avaneeshharshakamath10-dotcom/Intelligent_Road_Anomaly_Detection_System/detection_result.jpg

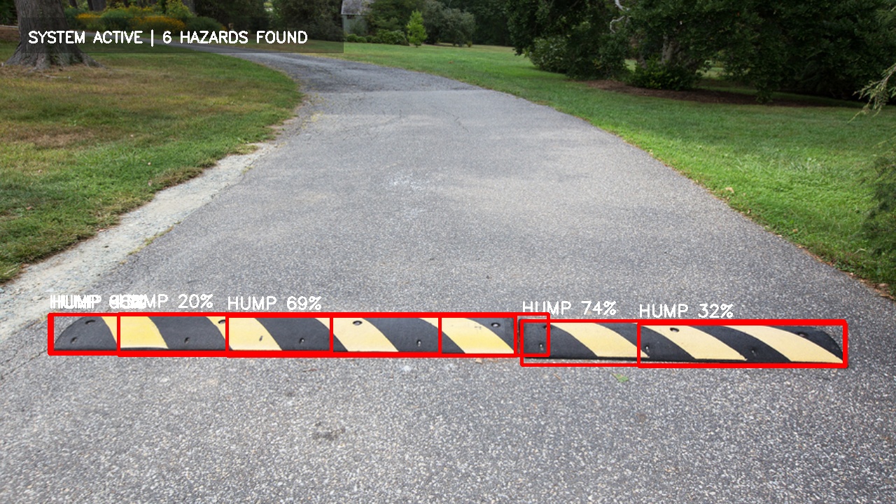
detection_result.jpg
