avaneeshharshakamath10-dotcom/Intelligent_Road_Anomaly_Detection_System/images.jpg

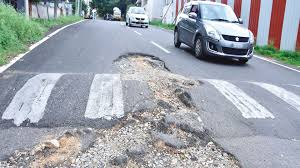
images.jpg
