avaneeshharshakamath10-dotcom/Intelligent_Road_Anomaly_Detection_System/BoxF1_curve.png

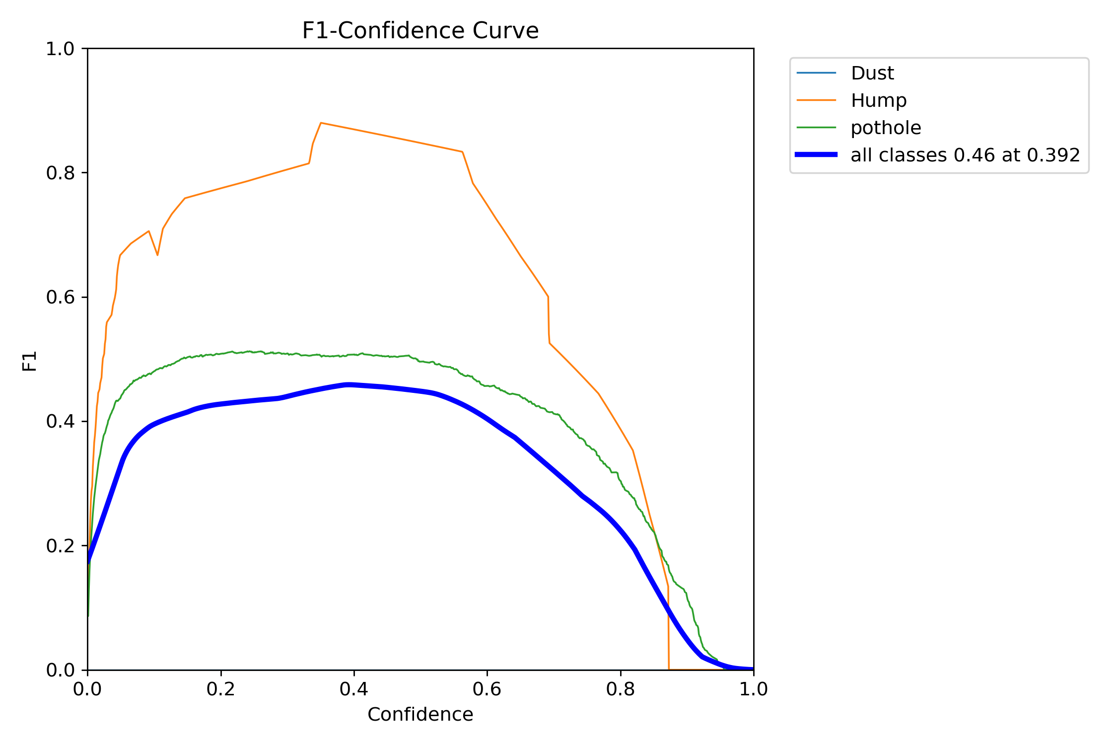
BoxF1_curve.png
