avaneeshharshakamath10-dotcom/Intelligent_Road_Anomaly_Detection_System/confusion_matrix_normalized.png

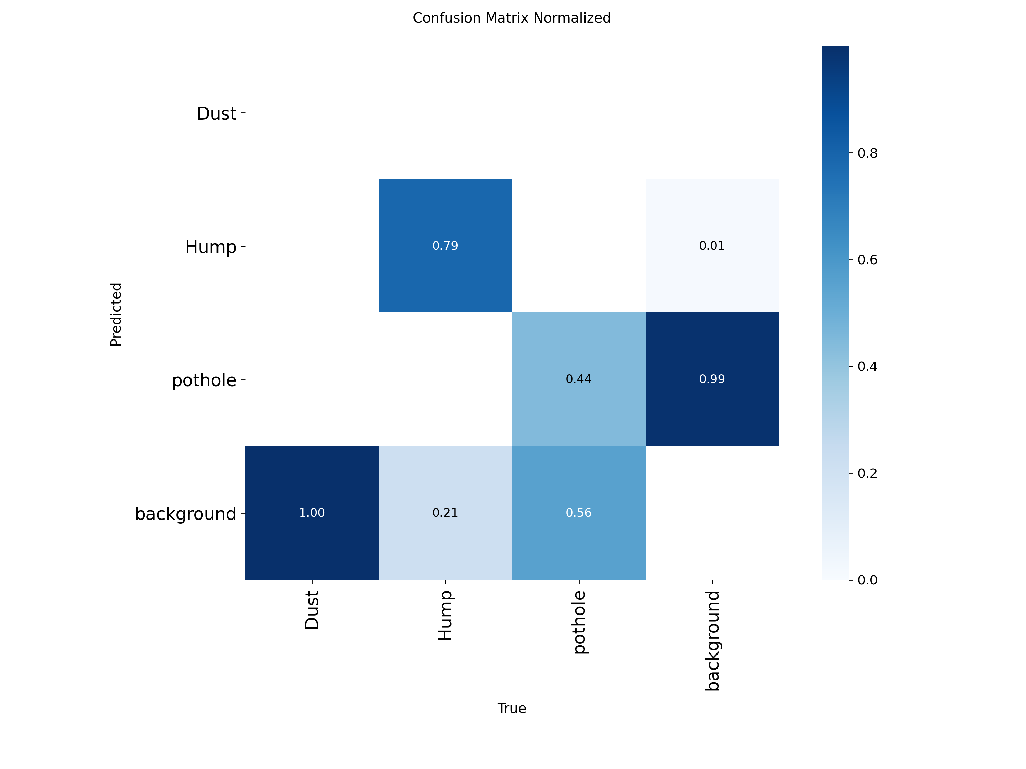
confusion_matrix_normalized.png
