avaneeshharshakamath10-dotcom/Intelligent_Road_Anomaly_Detection_System/MaskF1_curve.png

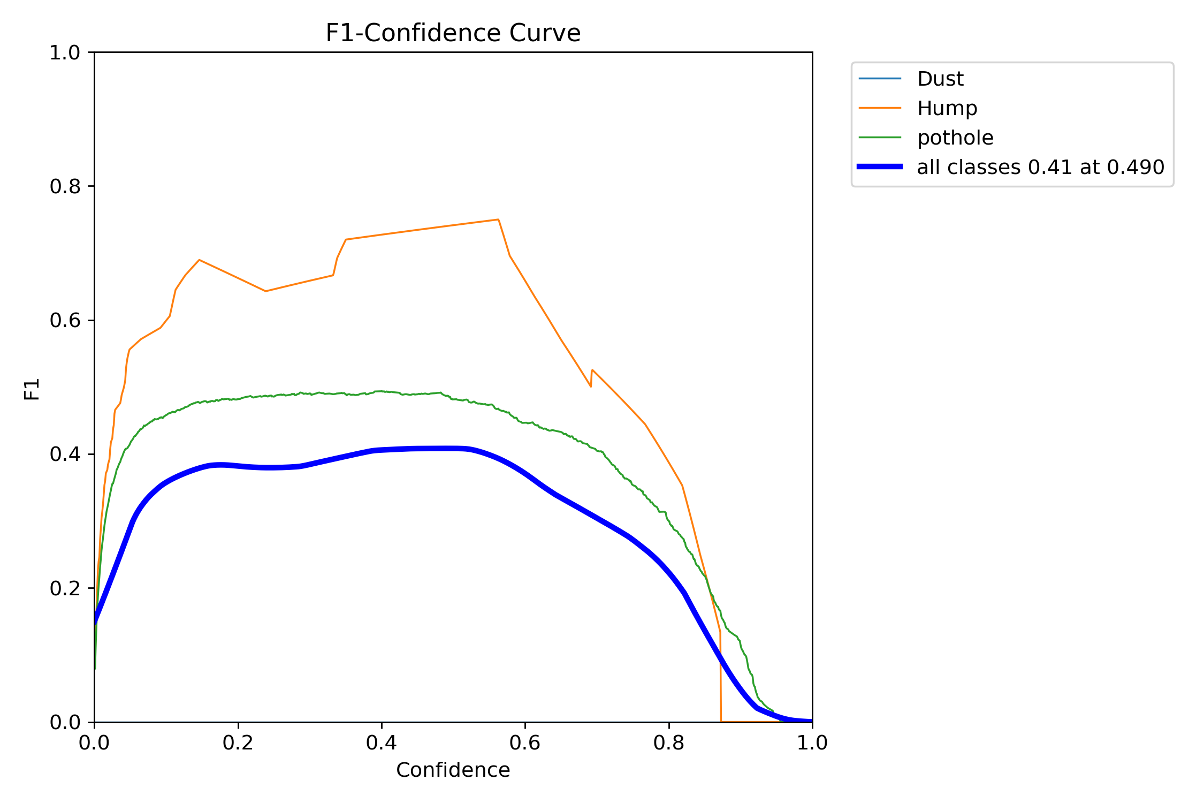
MaskF1_curve.png
