avaneeshharshakamath10-dotcom/Intelligent_Road_Anomaly_Detection_System/results.png

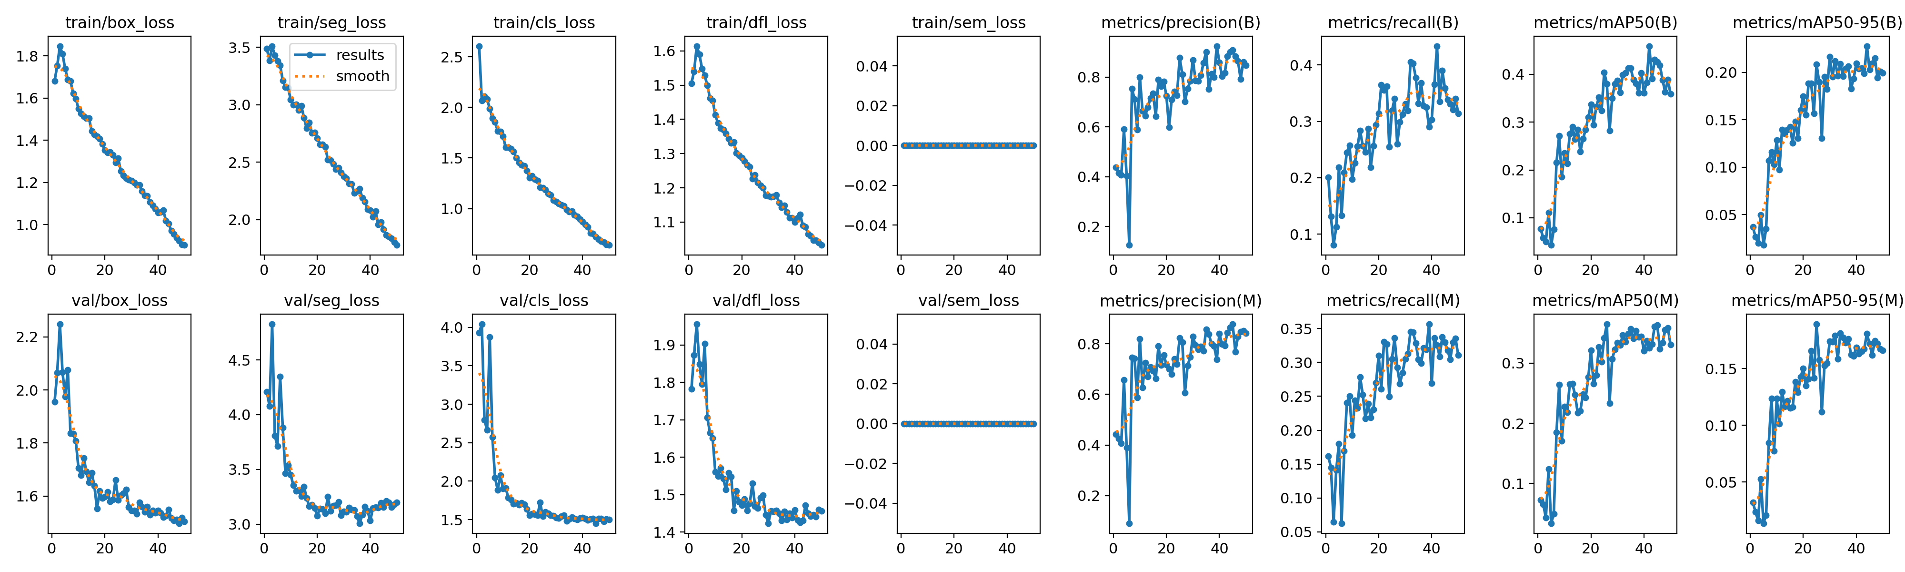
results.png
