avaneeshharshakamath10-dotcom/Intelligent_Road_Anomaly_Detection_System/main.h

#define MCO_Pin GPIO_PIN_0
#define MCO_GPIO_Port GPIOA
#define VCP_TX_Pin GPIO_PIN_2
#define VCP_TX_GPIO_Port GPIOA
#define CE_Pin GPIO_PIN_0
#define CE_GPIO_Port GPIOB
#define CSN_Pin GPIO_PIN_1
#define CSN_GPIO_Port GPIOB
#define SWDIO_Pin GPIO_PIN_13
#define SWDIO_GPIO_Port GPIOA
#define SWCLK_Pin GPIO_PIN_14
#define SWCLK_GPIO_Port GPIOA
#define VCP_RX_Pin GPIO_PIN_15
#define VCP_RX_GPIO_Port GPIOA
