avaneeshharshakamath10-dotcom/Intelligent_Road_Anomaly_Detection_System/(commit log)

2026-11-11 Results of trained yolov8s model
    [detection_log_1777028981.csv]
2026-11-11 Header files on STM32L432KC Transmitter Side
2026-11-11 Main body code of STM32L432KC Transmitter side
2026-11-11 Receiver side ESP32 code
