avaneeshharshakamath10-dotcom/Intelligent_Road_Anomaly_Detection_System/(notices)

Notices in the files:
main.c:
Copyright (c) 2026 STMicroelectronics.
All rights reserved.
This software is licensed under terms that can be found in the LICENSE file
